electron271/teensy-sdr/README.md

# teensy-sdr
SDR (Software Defined Radio) using a Teensy development board.

## Libraries
https://github.com/XenGi/teensy_library
https://github.com/XenGi/teensy.pretty
