electron271/teensy-sdr/teensy-sdr.kicad_pcb

## KiCad design teensy-sdr.kicad_pcb (2025-05-31)

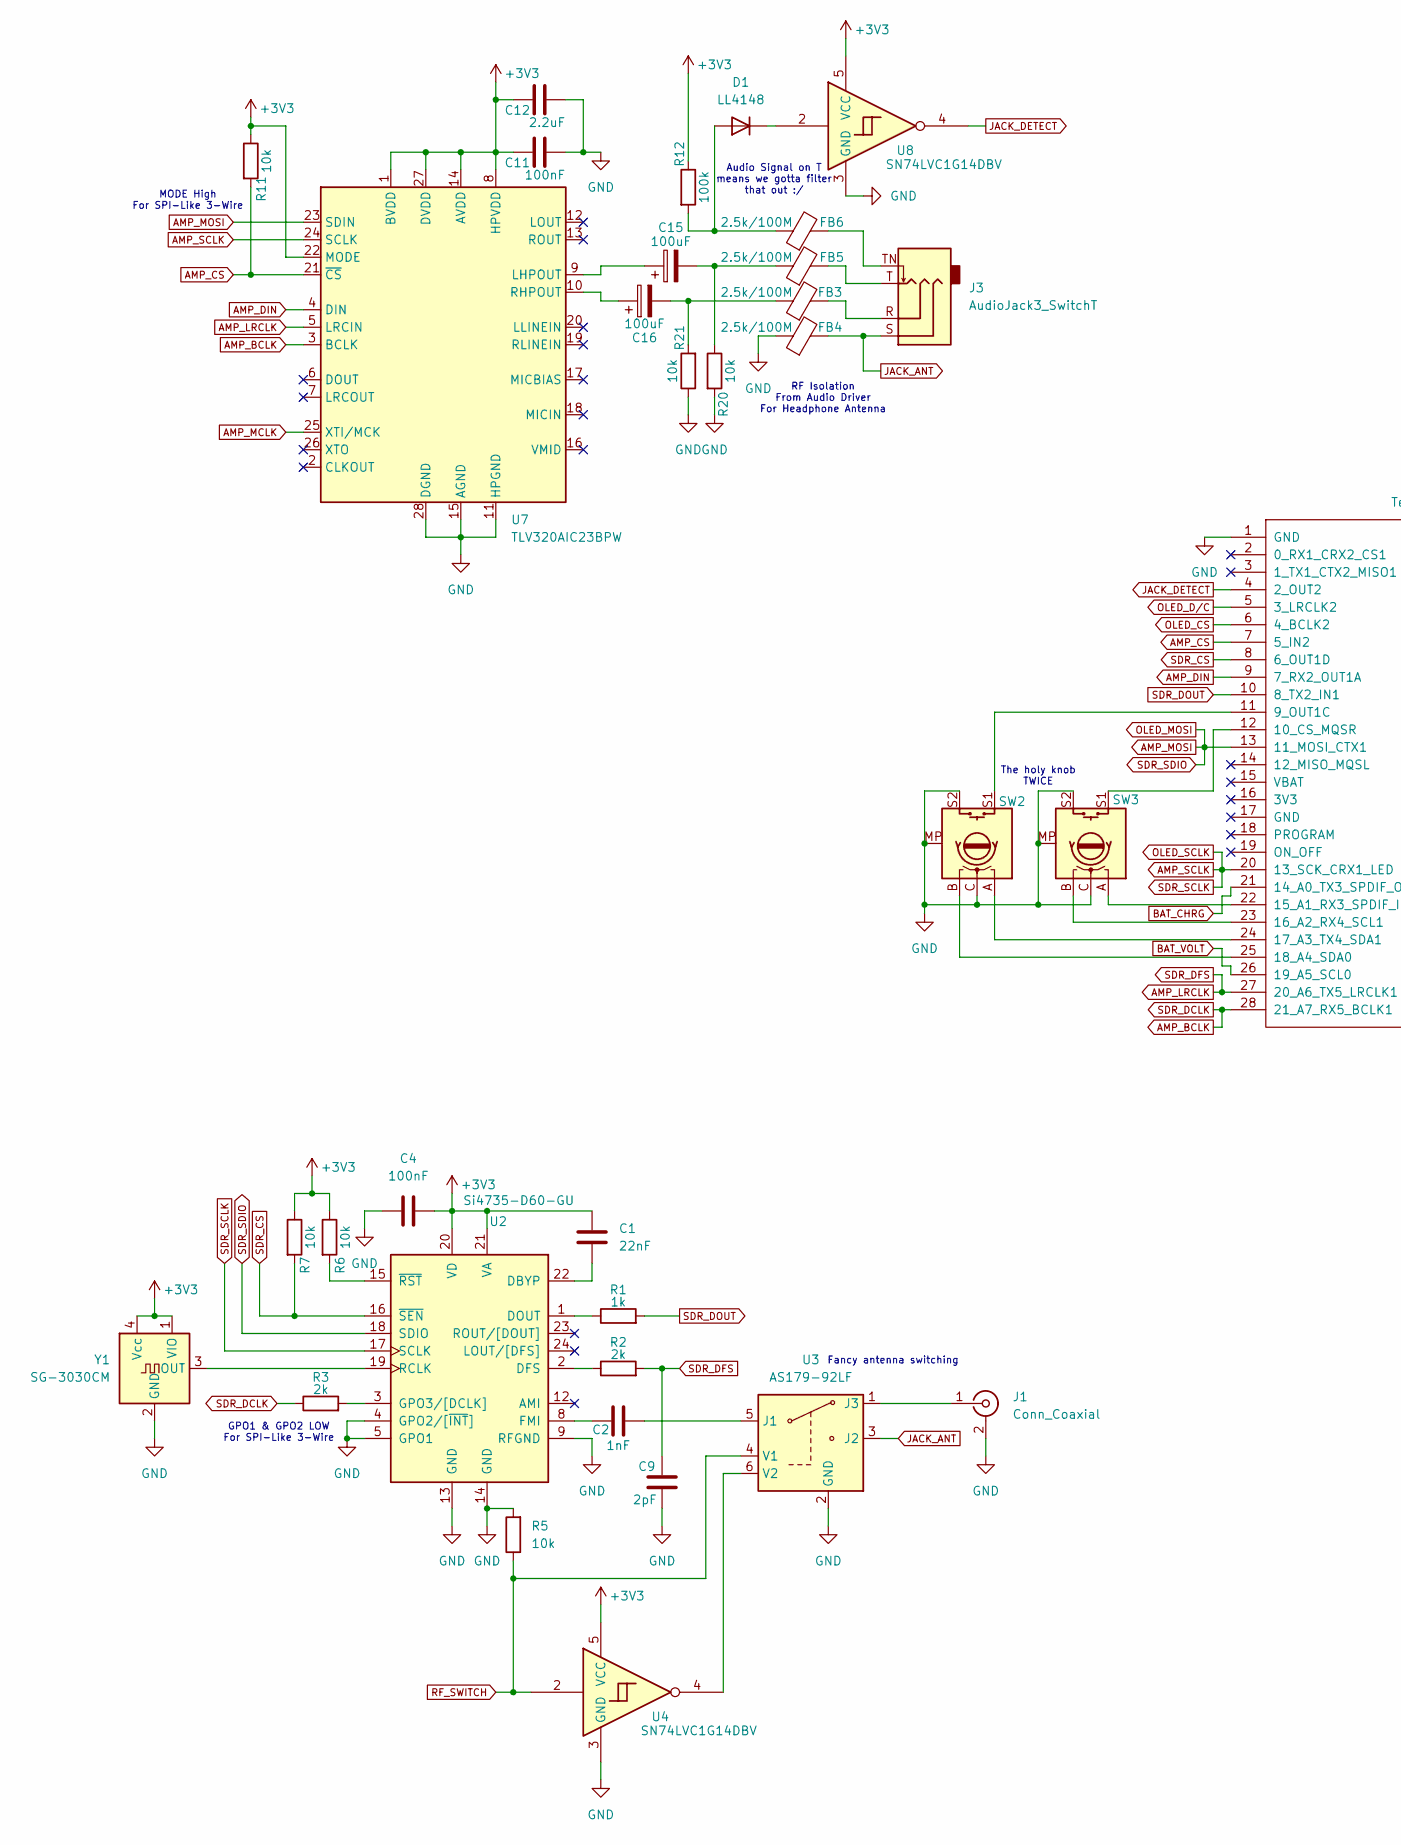
[picture p1: schematic teensy-sdr.kicad_sch, part in row 1, column 1]

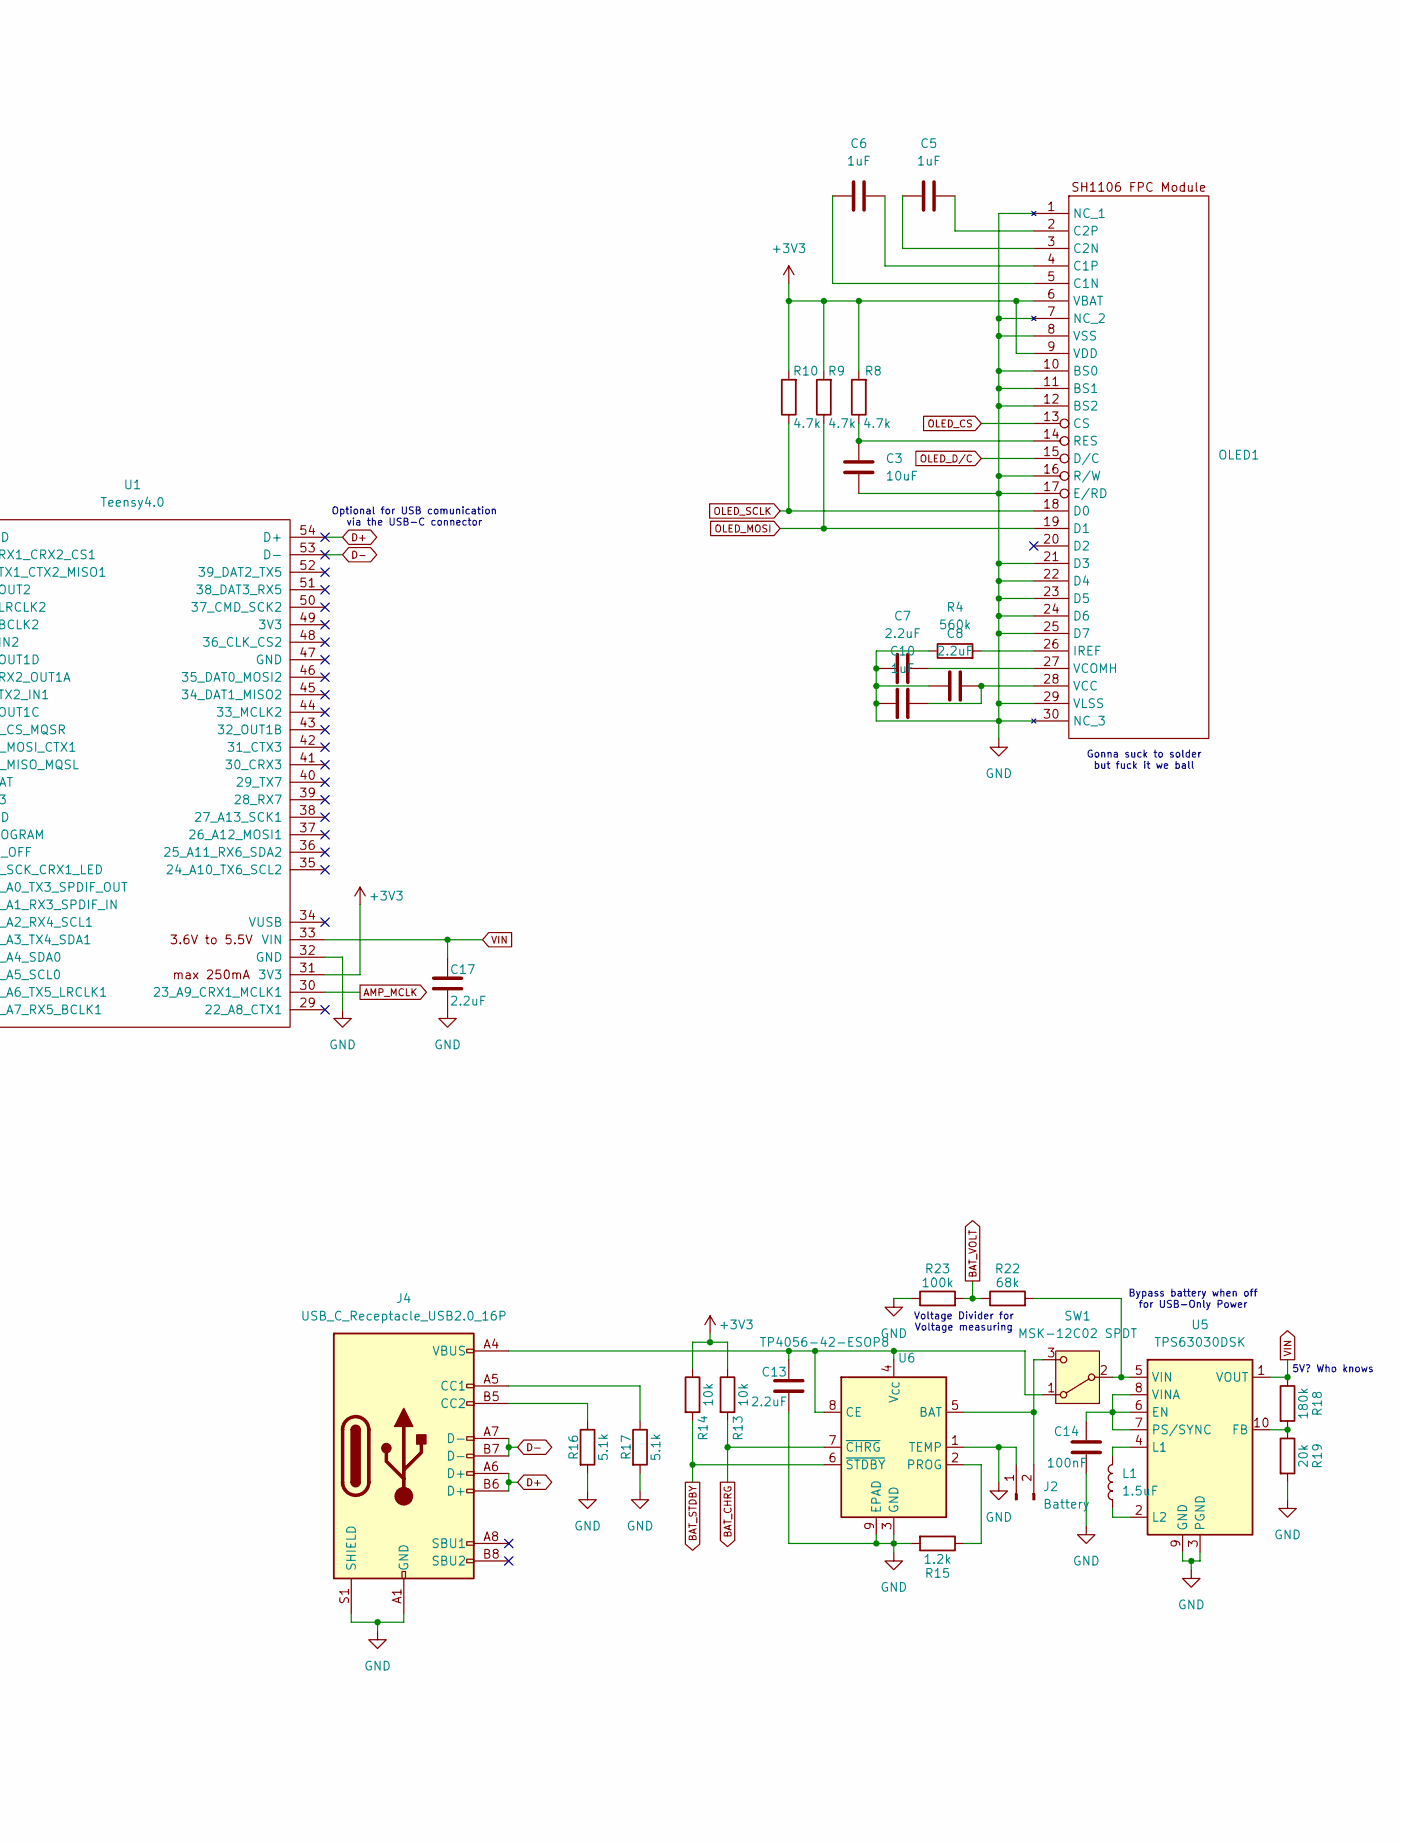
[picture p2: schematic teensy-sdr.kicad_sch, part in row 1, column 2]

Parts:
C1: 22nF; C_0805_2012Metric_Pad1.18x1.45mm_HandSolder; LCSC C107147
C2: 1nF; C_0805_2012Metric_Pad1.18x1.45mm_HandSolder; LCSC C94121
C3: 10uF; C_0805_2012Metric_Pad1.18x1.45mm_HandSolder; LCSC C15850
C4, C11, C14: 100nF; C_0805_2012Metric_Pad1.18x1.45mm_HandSolder; LCSC C49678
C5, C6, C10: 1uF; C_0805_2012Metric_Pad1.18x1.45mm_HandSolder; LCSC C28323
C7, C8, C12, C13, C17: 2.2uF; C_0805_2012Metric_Pad1.18x1.45mm_HandSolder; LCSC C28234
C9: 2pF; C_0805_2012Metric_Pad1.18x1.45mm_HandSolder; LCSC C519932
C15, C16: 100uF; CP_Radial_D8.0mm_P3.50mm; LCSC C2990945
D1: LL4148; D_MiniMELF; LCSC C68883
FB3, FB4, FB5, FB6: 2.5k/100M; L_0805_2012Metric_Pad1.05x1.20mm_HandSolder; LCSC C394486
J1: Conn_Coaxial; SMA_Molex_73251-1153_EdgeMount_Horizontal; LCSC C5859238
J2: Battery; JST_PH_B2B-PH-K_1x02_P2.00mm_Vertical; LCSC C20088550
J3: AudioJack3_SwitchT; Jack_3.5mm_CUI_SJ-3524-SMT_Horizontal; LCSC C22359753
J4: USB_C_Receptacle_USB2.0_16P; USB_C_Receptacle_GCT_USB4105-xx-A_16P_TopMnt_Horizontal; LCSC C3025063
L1: 1.5uF; L_7.3x7.3_H3.5; LCSC C5189745
OLED1: Untitled
R1: 1k; R_0805_2012Metric_Pad1.20x1.40mm_HandSolder; LCSC C95781
R2, R3: 2k; R_0805_2012Metric_Pad1.20x1.40mm_HandSolder; LCSC C114572
R4: 560k; R_0805_2012Metric_Pad1.20x1.40mm_HandSolder; LCSC C865557
R5, R6, R7, R11, R13, R14, R20, R21: 10k; R_0805_2012Metric_Pad1.20x1.40mm_HandSolder; LCSC C84376
R8, R9, R10: 4.7k; R_0805_2012Metric_Pad1.20x1.40mm_HandSolder; LCSC C60816
R12, R23: 100k; R_0805_2012Metric_Pad1.20x1.40mm_HandSolder; LCSC C96346
R15: 1.2k; R_0805_2012Metric_Pad1.20x1.40mm_HandSolder; LCSC C114526
R16, R17: 5.1k; R_0805_2012Metric_Pad1.20x1.40mm_HandSolder; LCSC C2930296
R18: 180k; R_0805_2012Metric_Pad1.20x1.40mm_HandSolder; LCSC C17501
R19: 20k; R_0805_2012Metric_Pad1.20x1.40mm_HandSolder; LCSC C114566
R22: 68k; R_0805_2012Metric_Pad1.20x1.40mm_HandSolder; LCSC C17801
SW1: MSK-12C02 SPDT; SW_MSK12C02-HB; LCSC C431540
SW2, SW3: RotaryEncoder_Alps_EC11E-Switch_Vertical_H20mm_MountingHoles; LCSC C1322542
U1: Teensy4.0; Teensy40_SMT
U2: Si4735-D60-GU; SSOP-24_3.9x8.7mm_P0.635mm; LCSC C17686189
U3: AS179-92LF; SOT-363_SC-70-6; LCSC C83422
U4, U8: SN74LVC1G14DBV; SOT-23-5; LCSC C7835
U5: TPS63030DSK; WSON-10-1EP_2.5x2.5mm_P0.5mm_EP1.2x2mm; LCSC C12462
U6: TP4056-42-ESOP8; SOIC-8-1EP_3.9x4.9mm_P1.27mm_EP2.41x3.3mm_ThermalVias; LCSC C16581
U7: TLV320AIC23BPW; TSSOP-28_4.4x9.7mm_P0.65mm; LCSC C9915
Y1: SG-3030CM; Oscillator_SMD_SeikoEpson_SG3030CM; LCSC C21058396

Connections:
+3V3: C1.1, C4.2, C11.2, C12.2, OLED1.6 (VBAT), OLED1.9 (VDD), R6.1, R7.1, R8.2, R9.2, R10.2, R11.1, R12.1, R13.1, R14.1, U1.31 (3V3), U2.20 (VD), U2.21 (VA), U4.5 (VCC), U7.1 (BVDD), U7.8 (HPVDD), U7.14 (AVDD), U7.22 (MODE), U7.27 (DVDD), U8.5 (VCC), Y1.1 (VIO), Y1.4 (Vcc)
AMP_BCLK: R3.1, U1.28 (21_A7_RX5_BCLK1), U7.3 (BCLK)
AMP_CS: R11.2, U1.7 (5_IN2), U7.21 (~CS)
AMP_DIN: U1.9 (7_RX2_OUT1A), U7.4 (DIN)
AMP_LRCLK: C9.2, R2.2, U1.27 (20_A6_TX5_LRCLK1), U7.5 (LRCIN)
AMP_MCLK: U1.30 (23_A9_CRX1_MCLK1), U7.25 (XTI/MCK)
AMP_MOSI: OLED1.19 (D1), R9.1, U1.13 (11_MOSI_CTX1), U2.18 (SDIO), U7.23 (SDIN)
AMP_SCLK: OLED1.18 (D0), R10.1, U1.20 (13_SCK_CRX1_LED), U2.17 (SCLK), U7.24 (SCLK)
BAT_CHRG: R13.2, U1.21 (14_A0_TX3_SPDIF_OUT), U6.7 (~CHRG)
BAT_STDBY: R14.2, U6.6 (~STDBY)
BAT_VOLT: R22.1, R23.2, U1.26 (19_A5_SCL0)
D+: J4.A6 (D+), J4.B6 (D+), U1.54 (D+)
D-: J4.A7 (D-), J4.B7 (D-), U1.53 (D-)
GND: C3.1, C4.1, C7.1, C8.1, C9.1, C10.1, C11.1, C12.1, C13.2, C14.2, C17.2, FB4.1, J1.2 (Ext), J2.1, J4.A1 (GND), J4.A12 (GND), J4.B1 (GND), J4.B12 (GND), J4.S1 (SHIELD), OLED1.1 (NC_1), OLED1.7 (NC_2), OLED1.8 (VSS), OLED1.10 (BS0), OLED1.11 (BS1), OLED1.12 (BS2), OLED1.16 (R/W), OLED1.17 (E/RD), OLED1.21 (D3), OLED1.22 (D4), OLED1.23 (D5), OLED1.24 (D6), OLED1.25 (D7), OLED1.29 (VLSS), OLED1.30 (NC_3), R4.1, R5.2, R15.2, R16.2, R17.2, R19.2, R20.2, R21.1, R23.1, SW1.MP, SW2.C, SW2.MP, SW2.S2, SW3.C, SW3.MP, SW3.S2, U1.1 (GND), U1.32 (GND), U2.4 (GPO2/[~INT]), U2.5 (GPO1), U2.9 (RFGND), U2.13 (GND), U2.14 (GND), U3.2 (GND), U4.3 (GND), U5.3 (PGND), U5.9 (GND), U5.11 (PGND), U6.1 (TEMP), U6.3 (GND), U6.9 (EPAD), U7.11 (HPGND), U7.15 (AGND), U7.28 (DGND), U8.3 (GND), Y1.2 (GND)
JACK_ANT: FB4.2, J3.S, U3.3 (J2)
JACK_DETECT: U1.4 (2_OUT2), U8.4
unnamed: C15.2, FB5.1, R20.1
unnamed: C16.2, FB3.1, R21.2
unnamed: D1.2 (A), FB6.1, R12.2
unnamed: D1.1 (K), U8.2
unnamed: FB3.2, J3.R
unnamed: FB5.2, J3.T
unnamed: FB6.2, J3.TN
unnamed: J1.1 (In), U3.1 (J3)
unnamed: J2.2, SW1.3 (C), U6.5 (BAT)
unnamed: J4.A5 (CC1), R17.1
unnamed: J4.B5 (CC2), R16.1
unnamed: C6.1, OLED1.5 (C1N)
unnamed: C6.2, OLED1.4 (C1P)
unnamed: C5.1, OLED1.3 (C2N)
unnamed: C5.2, OLED1.2 (C2P)
unnamed: OLED1.26 (IREF), R4.2
unnamed: C3.2, OLED1.14 (RES), R8.1
unnamed: C8.2, C10.2, OLED1.28 (VCC)
unnamed: C7.2, OLED1.27 (VCOMH)
unnamed: C13.1, J4.A4 (VBUS), J4.A9 (VBUS), J4.B4 (VBUS), J4.B9 (VBUS), SW1.1 (A), U6.4 (V_{CC}), U6.8 (CE)
unnamed: R22.2, SW1.2 (B), U5.5 (VIN)
unnamed: SW2.S1, U1.11 (9_OUT1C)
unnamed: SW3.S1, U1.12 (10_CS_MQSR)
unnamed: SW3.A, U1.22 (15_A1_RX3_SPDIF_IN)
unnamed: SW3.B, U1.23 (16_A2_RX4_SCL1)
unnamed: SW2.A, U1.24 (17_A3_TX4_SDA1)
unnamed: SW2.B, U1.25 (18_A4_SDA0)
unnamed: C1.2, U2.22 (DBYP)
unnamed: R2.1, U2.2 (DFS)
unnamed: R1.1, U2.1 (DOUT)
unnamed: C2.1, U2.8 (FMI)
unnamed: R3.2, U2.3 (GPO3/[DCLK])
unnamed: U2.19 (RCLK), Y1.3 (OUT)
unnamed: R6.2, U2.15 (~RST)
unnamed: C2.2, U3.5 (J1)
unnamed: U3.6 (V2), U4.4
unnamed: C14.1, U5.6 (EN), U5.7 (PS/SYNC), U5.8 (VINA)
unnamed: R18.2, R19.1, U5.10 (FB)
unnamed: L1.2, U5.4 (L1)
unnamed: L1.1, U5.2 (L2)
unnamed: R15.1, U6.2 (PROG)
unnamed: C15.1, U7.9 (LHPOUT)
unnamed: C16.1, U7.10 (RHPOUT)
OLED_CS: OLED1.13 (CS), U1.6 (4_BCLK2)
OLED_D/C: OLED1.15 (D/C), U1.5 (3_LRCLK2)
RF_SWITCH: R5.1, U3.4 (V1), U4.2
SDR_CS: R7.2, U1.8 (6_OUT1D), U2.16 (~SEN)
SDR_DOUT: R1.2, U1.10 (8_TX2_IN1)
VIN: C17.1, R18.1, U1.33 (VIN), U5.1 (VOUT)

Notes on the sheet:
RF Isolation From Audio Driver For Headphone Antenna
Audio Signal on T means we gotta filter that out :/
Bypass battery when off for USB-Only Power
Voltage Divider for Voltage measuring
Fancy antenna switching
MODE High For SPI-Like 3-Wire
Gonna suck to solder but fuck it we ball
Optional for USB comunication via the USB-C connector
GPO1 & GPO2 LOW For SPI-Like 3-Wire
The holy knob TWICE
5V? Who knows

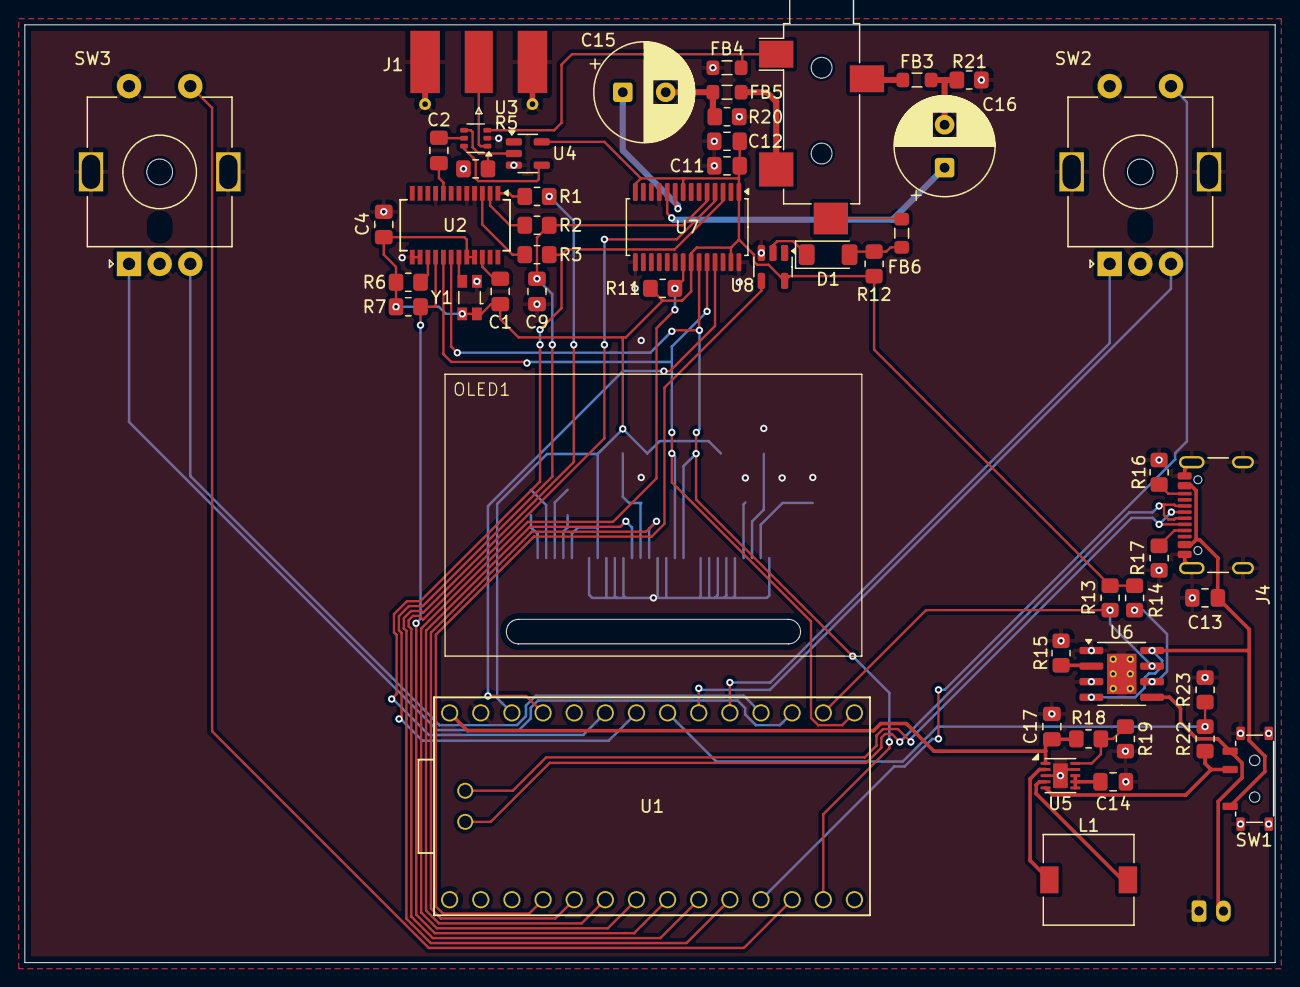
[picture p3: board teensy-sdr.kicad_pcb from above]

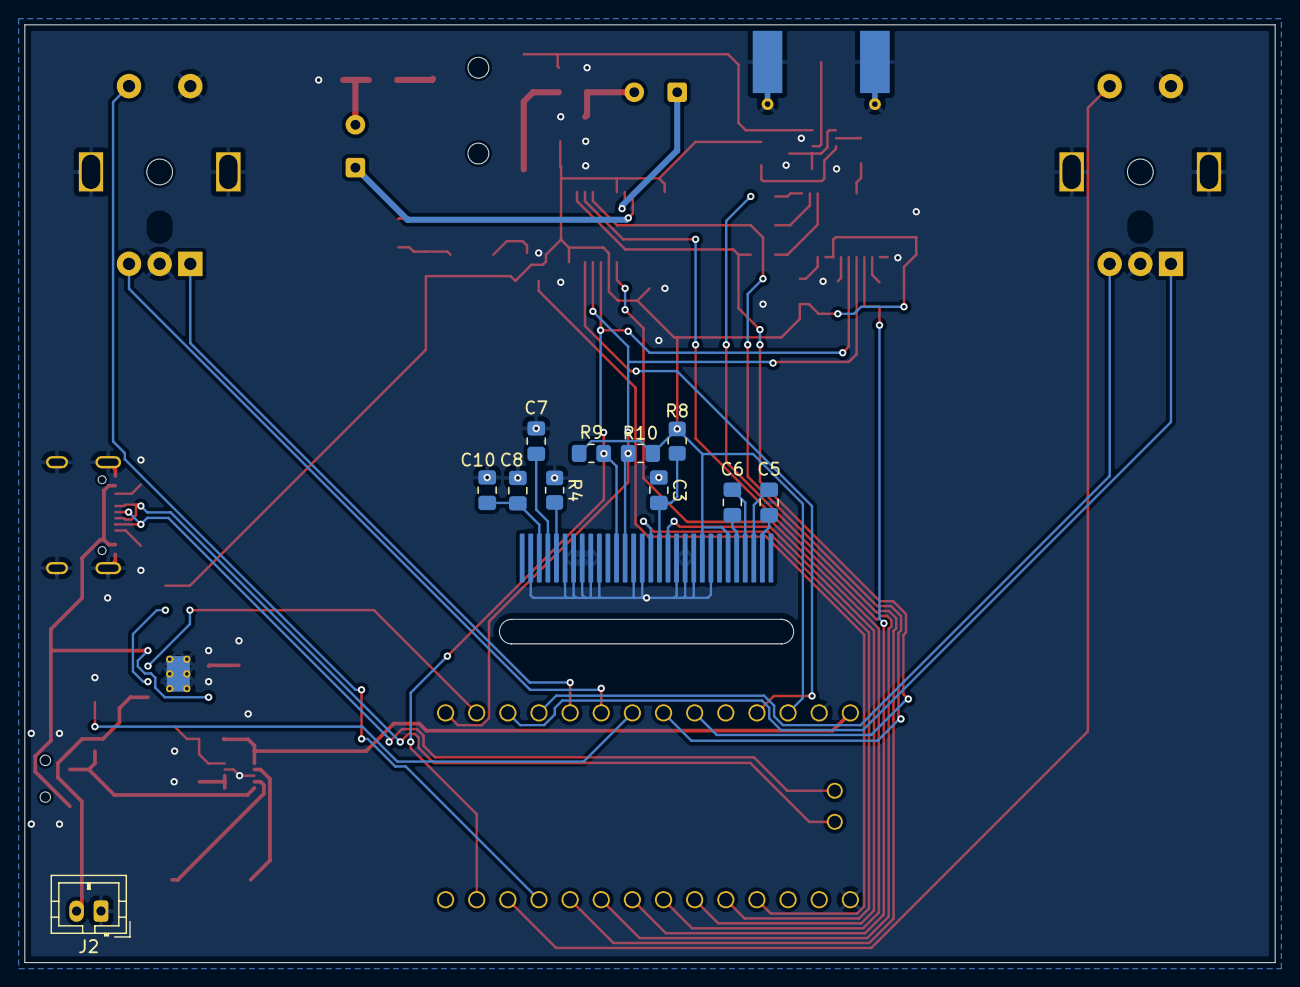
[picture p4: board teensy-sdr.kicad_pcb from below]

Board: 2 copper layers, 102.0 x 76.5 mm, 63 parts (11 on the bottom side), 65 nets.
