electron271/teensy-sdr/(commit log)

2025-05-28 idk what i am doin
    [teensy-sdr.kicad_pcb, teensy-sdr.kicad_sch]
2025-05-30 PCB Refractor
    [teensy-sdr.kicad_pcb, teensy-sdr.kicad_sch]
2025-05-30 remove graphics
    [teensy-sdr.kicad_pcb]
2025-05-31 fix swapped I2S lines
    [teensy-sdr.kicad_pcb, teensy-sdr.kicad_sch]
